gaborturu/aqua-gas-monitor/images/photo3.jpg

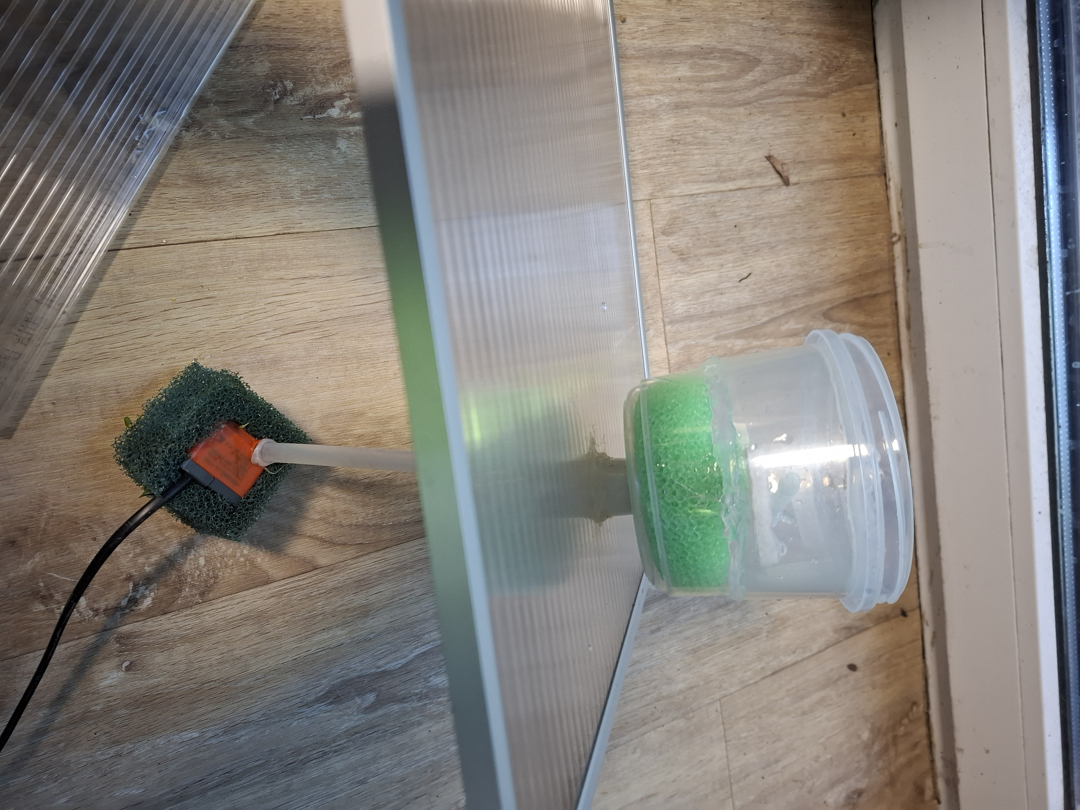
[picture p5: images/photo3.jpg]
images/photo3.jpg
